lucailvec/thermore_insulating_machine/report.odt

Manuale

La macchina per la misurazione dell’ RCT di un materiale richiede di: poter impostare la temperatura del piano riscaldato e dell’ambiente. Una volta posto il materiale sopra al piano e richiuso lo sportello la macchina deve raggiungere le temperature impostate e elaborando i dati acquisiti ricavare i valori RCT e CLO del materiale.

Per poter eseguire una rilevazione per prima cosa spegnere il dispositivo se non già spento. Per poterlo spegnere abbassare la leva del differenziale indicata con l’etichetta SUPPLY.

Aprire lo sportello e posizionare il materiale al di sopra del piatto. Richiudere correttamente lo sportello e alzare la leva SUPPLY.

A questo punto la macchina mostra a display che è entrata nello stato IDLE che consente all’operatore di impostare la temperatura della camera e la temperatura del corpo attraverso i bottoni indicati rispettivamente con AMB e PIATTO.

Nello stato IDLE la macchina monitora solamente i valori, il piatto riscaldante e il compressore non vengono attivati.

Una volta settata la temperatura desiderata è possibile premendo a fondo il bottone NEXT, questo farà passare lo stato del sistema allo stato HEATING.

Da ora in poi la macchina non richiede più l’intervento di un operatore ed è completamente autonoma.

Nello stato HEATING prima viene fatta raffreddare la camera climatica alla temperatura impostata, quando la temperatura rimane stabile viene acceso in modo graduale il piatto riscaldato.

Una volta che vengono rilevate 10 misurazioni in cui la mediana rilevata dalla temperatura del piatto e della camera oscillano in un intorno della temperatura impostata la macchina passa nello stato di MEASURAMENT.

In quest’ ultimo stato la macchina, che ha raggiunto uno stato stabile, esegue 40 rilevazioni della potenza utilizzata e una volta superate le 40 rilevazioni restituisce la mediana delle più recenti 40 rilevazioni.

Al termine delle rilevazioni è possibile spegnere la macchina tramite la leva SUPPLY aspettando lo spegnimento completo del DISPLAY per poter rieffettuare una nuova misura.

Scelte progettuali:

Software

Si è scelto di adottare una metodologia bottom-up con un primo obiettivo di realizzare un software o sketch che possa testare i singoli componenti.

Per far ciò si sono sviluppati i componenti software che mappassero i componenti collegati alla scheda di controllo Arduino quali NTC, piastre riscaldanti, teleruttori, display e bottoni.

Una volta costruiti i singoli componenti si è realizzato il programma che usasse ogni componente in modo che, una volta applicata la scheda alla macchina, si sarebbe potuto testare il funzionamento di ogni singolo componente. Questo codice verrà utilizzato per controllare che durante lo spostamento della macchina da un luogo ad un altro non si sia interrotto nessun cavo e che ogni componente non abbia smesso di funzionare.

E’ stata prevista anche la presenza di procedure automatiche di spegnimento nel caso di interruzione del collegamento con i sensori di temperatura per poter evitare il surriscaldamento eccessivo del piano riscaldante.

Una volta progettate le classi o componenti che rappresentano gli elementi reali si è deciso di inglobarli nei singoli controlli (Proporzionale-Integrativo-Derivativo con isteresi e senza) per la gestione della camera climatica(1) e delle componenti riscaldanti(2).

Per indicare la dispersione delle rilevazioni intorno alla media non viene usata la deviazione standard ma il coefficiente di variazione.

Più si avvicina allo zero più le rilevazioni sono nell’intorno della media e quindi le rilevazioni sono stabili.

https://it.wikipedia.org/wiki/Coefficiente_di_variazione

Per filtrare i valori della potenza e temperatura ottenuta dai sensori viene usata la mediana che fornisce un risultato più attendibile rispetto alla media in quanto è meno sensibile a valori lontani dalla media.

Per effettuare la regolazione del piatto riscaldante e della camera climatica si è deciso di implementare un controllore PID anagolico ed uno discreto inoltre è stata implementata una nuova funzionalità di controllo (proportional on measurement http://brettbeauregard.com/blog/2017/06/introducing-proportional-on-measurement/

).

I bottoni sono dotati di software anti-rimbalzo dove è settabile a piacere la frequenza di lettura.

Le fasi di display e invio al pc tramite USB dei dati è stato minimizzato, questo consente di avere un sistema più reattivo: anche per quanto riguarda l’utilizzo di display è stata prevista la possibilità di scegliere la frequenza di aggiornamento della schermata.

Per il display è stato pensato di sviluppare un sistema a finestre ed in modo ciclico è possibile scegliere quali elementi far mostrare sullo schermo.

Si è implementata la possibilità di limitare la potenza fornita ai piatti per evitare l’effetto “overshoot” dei controlli pid.

Hardware

E’ stata progettata una nuova scheda di controllo e sono stati eliminati tutti i fili pinwire con esclusione del connettore del display: ora accidentalmente è più difficile rimuovere un filo collegato.

Per gestire l’accensione e lo spegnimento della ventola di areazione e dei componenti riscaldanti si è utilizzato un mosfet ttl (https://www.sparkfun.com/products/10213) da sovradimensionato per le correnti in gioco. Questo consente di avere maggiori certezze sulla potenza erogata dal piano riscaldante.

La componente che governa l’accensione e lo spegnimento del compressore del frigo è rimasta invariata.

La ventola di raffreddamento è stata riposizionata per migliorare il raffreddamento.

Si è proceduto al ricablaggio completo di tutti i componenti impiegando canaline e scatole di derivazione.

Sono stati aggiunti dei led di segnalazione per mostrare l’accensione e lo spegnimento dei piatti riscaldanti: non servirà più aprire lo sportello per osservare se i componenti riscaldanti stanno lavorando.

E’ stato aggiunto un diodo di protezione verso l’alimentazione e un circuito di filtraggio dei disturbi verso le ntc.
