lucailvec/thermore_insulating_machine/Conclusioni.odt

Luca Vecchi

Giovedì 27 Agosto

Come da mail accennato la componente del frigorifero che dovrebbe raffreddare non raffredda.

Ieri dalle 18 alle 20:15 l’ho lasciata accesa con il piatto riscaldante spento e ha raggiunto la temperatura di 15°. Ho controllato anche mediante l’utilizzo di altre due sonde esterne (due termocoppie) che purtroppo indicavano la stessa temperatura fornita dal sensore installato nella macchina.

La taratura della macchina non sono riuscita a portarla a termine in quanto con 37 gradi di temperatura del piatto e 25 gradi dell’ambiente la temperatura dell’ambiente era costantemente al di sopra dei 26 gradi nonostante il frigo continuasse ad essere acceso e a raffreddare.

A questo punto ci sono varie possibilità tra cui:

- Ricaricare il frigo e verificare se la non refrigerazione era data dalla mancanza di gas causata a sua volta da una perdita.
- Sostituire il frigorifero

In ogni caso chiedo di poter procedere a portare la macchina da un frigorista per effettuare la ricarica del gas sottoponendolo prima ad una prova sotto vuoto per verificare eventuali perdite. Terminata la ricarica riprenderei la macchina sotto esame per rieffettuare la taratura delle componenti software alle varie temperature.

In attesa di un vostro riscontro

Luca Vecchi
