lucailvec/thermore_insulating_machine/RTC_MESUREMENT_MACHINE_0_1/RTC_MESUREMENT_MACHINE_0_1.ino

#include "include.h"
#include "pinout.h"
#include "setup.h"
#define DEBUG 2

//piatto vuoto 18.5 gradi
//2.32 minuti di prima oscillazione
Fridge fridge(FRIDGE);
Plate plate(PLATE, 255);
//Plate ring(RING, 180);

Button btnPUP(BTN_TEMP_PLATE_UP, 500);
Button btnPDOWN(BTN_TEMP_PLATE_DOWN, 500);
Button btnAUP(BTN_TEMP_AMB_UP, 500);
Button btnADOWN(BTN_TEMP_AMB_DOWN, 500);
Button btnNEXT(BTN_NEXT, 500);

WrapperButton buttonPlate(35, &btnPUP, &btnPDOWN,minTempPlate,maxTempPlate);
WrapperButton buttonAmb(20, &btnAUP, &btnADOWN,minTempAmb,maxTempAmb);

PCF8574_HD44780_I2C lcd(0x27,20,4);

#define RNOMINALE 100000
#define TNOMINALE 25
#define BCOEFF 3955

TempSensor tAmb(TEMP_AMB, BCOEFF, 297000, 100000, 25);
TempSensor tPlate(TEMP_PLATE, BCOEFF, 99800, 100000, 25);


//PID control

//Define Variables we'll be connecting to
double //Setpoint, è il valore del wrapper button
//tempPlate, //aggiornato tramite tPlate.getTemp();
outputPlate; //

//Specify the links and initial tuning parameters
//double KpPlate=2, KiPlate=1.2, KdPlate=0.0;
double KpPlate=2, KiPlate=0.3, KdPlate=0.0;

AnalogPid platePid(&tPlate.value, & outputPlate,& (buttonPlate.dValue) , KpPlate, KiPlate,KdPlate);

Fridge::STATE outputAmb;

double KpAmb=0.5, KiAmb=0.45;
double threshold = 5.0;
long interval = 20000;

DiscretePid fridgePid(&tAmb.value,&outputAmb, & (buttonAmb.dValue),KpAmb,KiAmb,interval,threshold);

//Statistics control

double _ar1[40];
Measurable statics1(500,_ar1,40);

const int NUMOFRCTMEASURE=75;
double _arRct[NUMOFRCTMEASURE];
Measurable cycleRCT(0,_arRct,NUMOFRCTMEASURE);
int counterRCT=-20;

double _ar2[20];
Measurable totalRCT(0,_ar2,20);
const long NUMMEASUREMENT=20;
int counterRCTCycle=0;

//variabili del supervisor

enum STATEMODE { NORMAL, RCTIDLE, MEASURESETUP, CLEAN, MEASURE, RCTINSERT, RCTINSERT1, RCTINSERT2, RCTINSERT3, RCTINSERTEND };
STATEMODE stateMode = STATEMODE::NORMAL;
int cifra;
double tempRCT;

enum STATE { IDLE, COOLING, HEATING, MEASUREMENT, END ,SELECTIONMODE};
STATE stato= STATE::IDLE;

const int intervalCallDisplay=1000,intervalDisplay=5000;
long lastDisplay=0,displayTimer1=0,displayTimer2=0;
long timeOfLoop;//,lastDisplay=0;;

long lastTimeReadStableState=0, intervalReadStableState=3500; 
unsigned int counterStableState=0;
const unsigned int NUMBEROFSTABLESTATE = 40;

void setup() {
  #ifdef DEBUG
    Serial.begin(2000000);
  #endif
  #ifdef DEBUG
    Serial.print("RCT0 20 C: "); buttonAmb.set(20); Serial.println(readRCT0(),4);
    Serial.print("RCT0 10 C: "); buttonAmb.set(10); Serial.println(readRCT0(),4);
    Serial.print("RCT0 0 C: "); buttonAmb.set(0); Serial.println(readRCT0(),4);
    Serial.print("RCT0 -10 C: "); buttonAmb.set(-10); Serial.println(readRCT0(),4);
    buttonAmb.set(20);
  #endif
 setLimit();
  
  lcd.init();                        
  lcd.backlight();      
  lcd.clear();

  pinMode(FAN,OUTPUT);
  analogWrite(FAN,255);
  delay(200);
  analogWrite(FAN,35);

  for(int i = 0 ; i < 5 ; i++){
  if(btnPUP.getState()==Button::STATE::DOWN && btnPDOWN.getState()==Button::STATE::DOWN){
    stato = STATE::SELECTIONMODE;
  }
  delay(100);
  }
}

void loop() {
  timeOfLoop=millis();
  /*supervisor.*/
  _update();// aggiorna ed esegue calcoli sui valori aggiornati
  /*supervisor.*/
  _run();//esegua le operazioni di modifica dello stato quale accensione o spegnimento degli elementi
  
  if(millis()- lastDisplay >= intervalCallDisplay){
    _display();//mostra a display i valori
    lastDisplay=millis();
/*
 lcd.setCursor(0,0);           lcd.print(F("Pmean: "));          lcd.print(statics1.median());
          lcd.setCursor(11,0);          lcd.print(F("Pcv: "));          lcd.print(statics1.cv());
          lcd.setCursor (0,1);          lcd.print(F("Tmean:  "));          lcd.print(statics2.median());
          lcd.setCursor(11,1);          lcd.print(F("Tcv:"));          lcd.print(statics2.cv());
 */
    #ifdef DEBUG
      Serial.print(F("OutAmb: "));
      Serial.print(outputPlate);
      Serial.print(F(" outPidAmb: "));
      Serial.print(fridgePid._output);
      Serial.print(F(" threshold: "));
      Serial.print(fridgePid._threshold);
      Serial.print(F(" | OutPlate: "));
      Serial.print(outputPlate);/*
      Serial.print(" outputMedian: ");
      Serial.print(statics1.median());
      Serial.print(" outputCv: ");
      Serial.print(statics1.cv());*/
      Serial.print(F(" dTime: "));
      Serial.println(millis() - timeOfLoop);
      Serial.print(F("TempPlate: "));
      Serial.print(tPlate.value);
      Serial.print(F(" SetPointPlate: "));
      Serial.println(buttonPlate.value);
      Serial.print(F("TempAmb: "));
      Serial.print(tAmb.value);
      Serial.print(F(" SetPointPlate: "));
      Serial.println(buttonAmb.value);
      Serial.print(F("Stato corrente: "));
      Serial.print(stato);
      Serial.print(F(" StateMode: "));
      Serial.print(stateMode);
      Serial.print(F(" RCT0: "));
      Serial.println(RCT0,3);
    #endif
  }

}

//var glob stato
void _run(){
  switch(stato){
    case STATE::IDLE:
      fridge.turn(Fridge::STATE::OFF);
    //  plate.turn(Plate::STATE::OFF);
      plate.set(0);
      break;
    case STATE::COOLING:
     // plate.turn(Plate::STATE::OFF);
      fridge.turn(outputAmb);
      analogWrite(FAN,255);
      break;
    case STATE::HEATING:
     // plate.turn(Plate::STATE::ON);
      analogWrite(FAN,30);
      fridge.turn(outputAmb);
      plate.set(outputPlate);
      break;
    case STATE::MEASUREMENT:
      fridge.turn(outputAmb);
      plate.set(outputPlate);
      break;
    case STATE::END:
      plate.turn(Plate::STATE::OFF);
      fridge.turn(outputAmb);
      plate.set(0);
      break;
    case STATE::SELECTIONMODE:
      fridge.turn(Fridge::STATE::OFF);
      plate.set(0);
    break;
  }
}

void _update(){
  switch(stato){
    case STATE::IDLE:
      tAmb.checkChange();
      tPlate.checkChange();
      buttonPlate.checkChange();
      buttonAmb.checkChange();
      
      if(btnNEXT.getState()==Button::STATE::DOWN){     
        if(stateMode==STATEMODE::CLEAN || stateMode==STATEMODE::MEASURE)
          RCT0 = 0;// lo prende dalla eeprom
        else
          RCT0 = readRCT0();
        stato=STATE::COOLING;
        displayTimer1=0;
        displayTimer2=0;
        lcd.clear();
       
      }
      
      break;
     case STATE::COOLING:
     
      tAmb.checkChange();
      tPlate.checkChange();
      fridgePid.compute();
        if(buttonAmb.value  + 0.3 >= tAmb.value ){
          stato=STATE::HEATING;
          displayTimer1=0;
          displayTimer2=0;
          break;
        }
      break;
      
    case STATE::HEATING:
      tAmb.checkChange();
      tPlate.checkChange();
      platePid.compute();
      fridgePid.compute();
     if(millis()-lastTimeReadStableState>= intervalReadStableState){
      if(buttonAmb.value - 1.6 <= tAmb.value && buttonAmb.value + 0.8 >= tAmb.value && buttonPlate.value - 0.8 <= tPlate.value && buttonPlate.value + 1.0 >= tPlate.value){
        counterStableState++;
      }
       else{
        counterStableState=0;
       }
        lastTimeReadStableState= millis();
      }
      //counter time is : NUMBEROFSTABLESTATE * itnervalReadStableState
      if(counterStableState==NUMBEROFSTABLESTATE){
     // if(counterStableState==3){
          stato=STATE::MEASUREMENT;
          displayTimer1=0;
          displayTimer2=0;
          lcd.clear();
          //todo azzerare statics1 e 2
          statics1.reset();
      }
    break;
    
    case STATE::MEASUREMENT:

    if(btnNEXT.getState()==Button::STATE::DOWN){
       if(stateMode==STATEMODE::MEASURE){
             writeRCT0(totalRCT.average(counterRCTCycle));
          }
        stato=STATE::END;
        displayTimer1=0;
        displayTimer2=0;
        lcd.clear();
      }
    
      tAmb.checkChange();
      tPlate.checkChange();
      platePid.compute();
      fridgePid.compute();

      statics1.newVal(outputPlate);

      if(counterRCT>=NUMOFRCTMEASURE){
          if(counterRCTCycle>=NUMMEASUREMENT){
            if(stateMode==STATEMODE::MEASURE){
             writeRCT0(totalRCT.average(counterRCTCycle));
            }
            stato=STATE::END;
            displayTimer1=0;
            displayTimer2=0;
            lcd.clear();
          }else{
            /*if(stateMode==STATEMODE::MEASURE){
              
            }else{*/
             totalRCT.newVal(cycleRCT.median(counterRCT));
            
            counterRCT=0;
            counterRCTCycle++;
          }
      }

     if(millis()-lastTimeReadStableState>= intervalReadStableState){
      if(counterRCT<=-1){
       counterRCT++;
      }else {
        double tempRCT = convertToRCT(statics1.median(counterRCT),tPlate.value,tAmb.value);
        /*if(tempRCT<=0.010||tempRCT >= 10)
          break;*/
        counterRCT++;
        if(stateMode == STATEMODE::MEASURE || stateMode==STATEMODE::CLEAN){
         cycleRCT.newVal((tempRCT));
        }else 
          cycleRCT.newVal( normalize(tempRCT));
      }
      
      lastTimeReadStableState=millis();
     }

     
      break;

    case STATE::END:
      tAmb.checkChange();
      tPlate.checkChange();
      fridgePid.compute();
      plate.turn(Plate::STATE::OFF);
      
  
      
      if(btnNEXT.getState()==Button::STATE::DOWN){
        stateMode=STATEMODE::NORMAL;
        stato=STATE::IDLE;
        displayTimer1=0;
        displayTimer2=0;
        lcd.clear();
        counterRCT=-30;
      }
      break;

    case STATE::SELECTIONMODE://inseriamo un rct er 20,10,0 e -10 
      if(millis()-lastTimeReadStableState>= 200){
        tAmb.checkChange();
        tPlate.checkChange(); //NORMAL, RCTIDLE, RCTAMBTEMPSELECTION, RCTMEASURE
  
        //cambiare la modalità
        if(stateMode==STATEMODE::NORMAL || stateMode == STATEMODE::RCTIDLE || stateMode == STATEMODE::MEASURESETUP || stateMode ==STATEMODE::CLEAN)
          if(btnPUP.getState() == Button::STATE::DOWN || btnPDOWN.getState() == Button::STATE::DOWN){
            lcd.clear();
            switch(stateMode){
              case STATEMODE::NORMAL: stateMode = STATEMODE::RCTIDLE; break;
              case STATEMODE::RCTIDLE: stateMode = STATEMODE::MEASURESETUP; break;
              case STATEMODE::MEASURESETUP: stateMode = STATEMODE::CLEAN; break;
              case STATEMODE::CLEAN: stateMode = STATEMODE::NORMAL; break;
            }
          }
  
        switch(stateMode){
            case STATEMODE::MEASURE: 
              if(btnAUP.getState() == Button::STATE::DOWN || btnADOWN.getState() == Button::STATE::DOWN){
              
              if(buttonAmb.value -10 <= -20)
                 buttonAmb.set(20);
              else
                 buttonAmb.set(buttonAmb.value -10);
            }
            break;
           case STATEMODE::RCTINSERT:
             if(btnAUP.getState() == Button::STATE::DOWN || btnADOWN.getState() == Button::STATE::DOWN){
              if(buttonAmb.value -10 <= -20)
                 buttonAmb.set(20);
              else
                 buttonAmb.set(buttonAmb.value -10);
             }
           break;
           case STATEMODE::RCTINSERT1:
           case STATEMODE::RCTINSERT2:
           case STATEMODE::RCTINSERT3:
                if(btnPUP.getState() == Button::STATE::DOWN)
                  cifra++;
                else if (btnPDOWN.getState() == Button::STATE::DOWN)
                  cifra--;
                break;
          }
        
        if(btnNEXT.getState()==Button::STATE::DOWN){
          switch(stateMode){
            case STATEMODE::NORMAL: stato = STATE::IDLE; break;
            case STATEMODE::RCTIDLE: stateMode = STATEMODE::RCTINSERT; break;
            case STATEMODE::MEASURESETUP: stateMode = STATEMODE::MEASURE; break;
            case STATEMODE::MEASURE: stato= STATE::COOLING; break;
            case STATEMODE::RCTINSERT: stateMode = STATEMODE::RCTINSERT1;tempRCT= 0.; cifra=5; break;
            case STATEMODE::RCTINSERT1: tempRCT += 0.1 * cifra; cifra = 5; stateMode = STATEMODE::RCTINSERT2; break;
            case STATEMODE::RCTINSERT2: tempRCT += 0.01 * cifra; cifra = 5; stateMode = STATEMODE::RCTINSERT3; break;
            case STATEMODE::RCTINSERT3: tempRCT += 0.001 * cifra; cifra = 5; stateMode = STATEMODE::RCTINSERTEND; writeRCT0(tempRCT); break;
            case STATEMODE::RCTINSERTEND: writeRCT0(tempRCT);
            case STATEMODE::CLEAN: stato = STATE::IDLE; break;
          }
            //displayTimer1=0;
            displayTimer2=0;
            lcd.clear();
       }
       lastTimeReadStableState=millis();
      }
  }
}

//long intervalDisplay=3000,lastDisplay=0,displayTimer1=0,displayTimer2=0,_numMesurement=30;

//var glob stato
void _display(){
  if(displayTimer1==0 && displayTimer2==0)
   displayTimer2=millis();
  switch(stato){
    case STATE::IDLE:
      if(displayTimer1==0){//diplayTimer1 mostra a che fase è del singolo stato mentre displayTimer2 indica quale informazione stampare a video
         lcd.setCursor(0,0);          lcd.print(F("Stato: IDLE"));
         lcd.setCursor(0,2);          lcd.print(F("POI premi  NEXT"));
         lcd.setCursor(0,1);          lcd.print(F("Sett. la temp"));
         if(millis() - displayTimer2 >= intervalDisplay){
            displayTimer1=1;
            lcd.clear();
         }
      }else{
        lcd.setCursor(0,0);        lcd.print(F("Ta: "));        lcd.print(tAmb.value,1);
        lcd.setCursor(12,0);        lcd.print(F("Tap:"));        lcd.print(buttonAmb.dValue,1);
        lcd.setCursor (0,1);        lcd.print(F("Tc:  "));        lcd.print(tPlate.value,1);
        lcd.setCursor(12,1);        lcd.print(F("Tcp:"));        lcd.print(buttonPlate.value);
     }
      if(stateMode == STATEMODE::CLEAN){
        lcd.setCursor(0,3); lcd.print(F("Bps rct0 e tarat."));
      }else{
        lcd.setCursor(0,3); lcd.print(F("Rct0: ")); lcd.print(readRCT0(),4);
      }
      
      break;
    case STATE::COOLING:
      if(displayTimer1==0){
       lcd.setCursor(0,0);        lcd.print(F("Stato: COOLING"));       
       lcd.setCursor(0,2) ;        lcd.print(F("Fase di raffreddamento"));
       lcd.setCursor(0,1);        lcd.print(F("Attendere prego."));
       if(millis() - displayTimer2 >= intervalDisplay){
        displayTimer1=1;
        lcd.clear();
       }
      }else{
        lcd.setCursor(0,0);          lcd.print(F("Ta: "));          lcd.print(tAmb.value,1);
        lcd.setCursor(0,1);          lcd.print(F("Tap:"));          lcd.print(buttonAmb.dValue,1);
        //lcd.setCursor (0,2);         lcd.print(F("T da raggiungere:  "));  
        //lcd.setCursor(0,3); lcd.print(calculateCollingValue(buttonAmb.dValue),1);
      }
    break;
    case STATE::HEATING:
      if(displayTimer1==0){
       lcd.setCursor(0,0);        lcd.print(F("Stato: HEATING"));       
       lcd.setCursor(0,2) ;        lcd.print(F("Fase di stabilizzazione"));
       lcd.setCursor(0,1);        lcd.print(F("Attendere prego."));
       if(millis() - displayTimer2 >= intervalDisplay){
        displayTimer1=1;
        displayTimer2=millis();
        lcd.clear();
       }
      }else if(displayTimer1==1) {
          lcd.setCursor(0,0);          lcd.print(F("Ta: "));          lcd.print(tAmb.value,1);
          lcd.setCursor(12,0);          lcd.print(F("Tap:"));          lcd.print(buttonAmb.dValue,1);
          lcd.setCursor (0,1);         lcd.print(F("Tc:  "));          lcd.print(tPlate.value,1);
          lcd.setCursor(12,1);          lcd.print(F("Tcp:"));          lcd.print(buttonPlate.value);
          if(millis() - displayTimer2 >= intervalDisplay){
            displayTimer1=2;
            displayTimer2=millis();
            lcd.clear();
           }
       }else if (displayTimer1==2){
          lcd.setCursor(0,0);           lcd.print(F("OutP: "));          lcd.print(outputPlate);
          //lcd.setCursor(11,0);          lcd.print(F("Pcv: "));          lcd.print(statics1.cv());
          lcd.setCursor (0,1);          lcd.print(F("OutA: "));          lcd.print(outputAmb);
          //lcd.setCursor(11,1);          lcd.print(F("Tcv:"));          lcd.print(statics2.cv());
          lcd.setCursor(0,2);          lcd.print(F("countSS:"));          lcd.print(counterStableState);
          lcd.setCursor(0,3); lcd.print(F("Goal: ")); lcd.print(NUMBEROFSTABLESTATE);
          if(millis() - displayTimer2 >= intervalDisplay){
            displayTimer1=1;
            displayTimer2=millis();
            lcd.clear();
           }
        }
      
      break;
    case STATE::MEASUREMENT://TODO
      if(displayTimer1==0){//diplayTimer1 mostra a che fase è del singolo stato mentre displayTimer2 indica quale informazione stampare a video
        lcd.setCursor(0,0);        lcd.print(F("Stato: MISURA"));       
       lcd.setCursor(0,1);        lcd.print(F("Campion. in corso."));
       lcd.setCursor(0,2) ;        lcd.print(F("Premere next per fermare le misurazioni"));
        if(millis() - displayTimer2 >= intervalDisplay){
            displayTimer1=1;
            lcd.clear();
         }
      }else if(displayTimer1==1) {
            if(counterRCT >= 0 ){
              double temp=cycleRCT.median(counterRCT);
              lcd.setCursor(0,0);         lcd.print(F("RCTinst: "));        lcd.print(temp,4);
              lcd.setCursor(0,1);        lcd.print(F("CLOinst: "));        lcd.print(rct2Clo(temp),4);
              temp=totalRCT.average(counterRCTCycle);
              if(counterRCTCycle>=1){
              lcd.setCursor(0,2);         lcd.print(F("RCTm: "));        lcd.print(temp,4);
              lcd.setCursor(0,3);        lcd.print(F("CLOm: "));        lcd.print(rct2Clo(temp),4);
              }
              else{
                lcd.setCursor(0,2);         lcd.print(F("RCTm: wait")); 
                lcd.setCursor(0,3);        lcd.print(F("CLOm: wait")); 
              }
               if(millis() - displayTimer2 >= intervalDisplay){
                displayTimer1=2;
                displayTimer2=millis();
                lcd.clear();
               }
            }else{
              lcd.setCursor(0,2);         lcd.print(F("Campion. di stabilz."));
              lcd.setCursor(0,3);         lcd.print(F("in corso "));
            }
      }else if (displayTimer1==2){
        lcd.setCursor(0,0);         lcd.print(F("Ta: "));        lcd.print(tAmb.value,1);   lcd.print(F(" Tc: "));        lcd.print(tPlate.value,1);
        lcd.setCursor(0,2); lcd.print(F("N inst: ")); lcd.print(counterRCT); lcd.print(F(" di: ")); lcd.print(NUMOFRCTMEASURE);
        lcd.setCursor(0,3); lcd.print(F("N media: ")); lcd.print(counterRCTCycle); lcd.print(F(" di: ")); lcd.print(NUMMEASUREMENT);
        
        if(millis() - displayTimer2 >= intervalDisplay){
          displayTimer1=1;
          displayTimer2=millis();
          lcd.clear();
         }
       }
      
      break;

    case STATE::END:   
      if(displayTimer1==0){//diplayTimer1 mostra a che fase è del singolo stato mentre displayTimer2 indica quale informazione stampare a video
         lcd.setCursor(0,0);          lcd.print(F("Misura conclusa."));
         lcd.setCursor(0,1);          lcd.print(F("Premi NEXT per"));
         lcd.setCursor(0,2);          lcd.print(F("riavviare la macchina"));
         if(millis() - displayTimer2 >= intervalDisplay + 10000){
            displayTimer1=1;
            lcd.clear();
         }
      }else{
        if(stateMode==STATEMODE::MEASURE){
          lcd.setCursor(0,0);        lcd.print(F("Rct0 calcolato: "));       
          lcd.setCursor (0,1);        lcd.print(F("RCT0 medio: "));        lcd.print(readRCT0(),4);
          lcd.setCursor(0,2); lcd.print(F("Tamb: ")); lcd.print(buttonAmb.value);
          lcd.setCursor(0,3); lcd.print(F("Riaccendi la macchina")); 
         }else if (stateMode== STATEMODE::CLEAN){
          lcd.setCursor(0,0);        lcd.print(F("Rct senza taratura"));       
          lcd.setCursor (0,1);        lcd.print(F("RCT medio: "));       lcd.print(totalRCT.average(counterRCTCycle),4);
          lcd.setCursor(0,2); lcd.print(F("Tamb: ")); lcd.print(buttonAmb.value);
          lcd.setCursor(0,3); lcd.print(F("Riaccendi la macchina")); 
         } else{
        lcd.setCursor(0,0);        lcd.print(F("Ta: "));        lcd.print(buttonAmb.value,1);     lcd.print(F(" Tp:"));        lcd.print(buttonPlate.dValue,1);
        lcd.setCursor (0,1);        lcd.print(F("RCT medio:  "));        lcd.print(totalRCT.average(counterRCTCycle),4);
        lcd.setCursor(0,2);        lcd.print(F("Clo medio:"));        lcd.print(rct2Clo(totalRCT.average(counterRCTCycle)),4);
        lcd.setCursor(0,3); lcd.print(F("Calc. su ")); lcd.print(counterRCTCycle);
         }
     }
      break;
     case STATE::SELECTIONMODE:
         if(displayTimer1==0){//diplayTimer1 mostra a che fase è del singolo stato mentre displayTimer2 indica quale informazione stampare a video
         lcd.setCursor(0,0);          lcd.print(F("Stato: config"));
         lcd.setCursor(0,1);        lcd.print(F("Usa btn PIATTO")); 
         lcd.setCursor(0,2); lcd.print(F("cambiare la mod."));  
         lcd.setCursor(0,3); lcd.print(F("Conferma con NEXT"));       
          
         if(millis() - displayTimer2 >= intervalDisplay + 4000){
            displayTimer1=1;
            displayTimer2=millis();
            lcd.clear();
         }
      }else{
        
          
         /* if(millis() - displayTimer2 >= intervalDisplay + 10000){
              displayTimer1=1;
              lcd.clear();
           */   
          switch(stateMode){
          case STATEMODE::NORMAL: lcd.setCursor(0,0);          lcd.print(F("Mod: normale")); lcd.setCursor(0,1); lcd.print(F("Premi NEXT per")); lcd.setCursor(0,2); lcd.print(F("fare una misura")); break;
          case STATEMODE::CLEAN: lcd.setCursor(0,0);          lcd.print(F("Mod: clean"));  lcd.setCursor(0,1); lcd.print(F("Senza rct0 e tar.")); lcd.setCursor(0,2); lcd.print(F("Premi NEXT per")); lcd.setCursor(0,3); lcd.print(F("fare una misura")); break;
          case STATEMODE::RCTIDLE: lcd.setCursor(0,0);          lcd.print(F("Mod: inserimento")); break;
          case STATEMODE::MEASURE:lcd.setCursor(0,0);          lcd.print(F("Con Amb selez")); 
              lcd.setCursor(0,1); lcd.print(F("la temp. poi NEXT")); 
             lcd.setCursor(0,1);          lcd.print(F("Premi NEXT per misura.")); 
          lcd.setCursor(0,2);   lcd.print(F("TempAmb: ")); lcd.print(buttonAmb.dValue);
          lcd.setCursor(0,3);   lcd.print(F("RCTO salv: ")); lcd.print(readRCT0(),3);
          break;
          case STATEMODE::MEASURESETUP: lcd.setCursor(0,0); lcd.print(F("Mod: misura")); lcd.setCursor(0,1); lcd.print(F("Misura, salva l'rct0")); break;
         case STATEMODE::RCTINSERT: lcd.setCursor(0,0);   lcd.print(F("Inserisci la tAmb")); 
          lcd.setCursor(0,1);   lcd.print(F("Usa btnAmb poi NEXT"));
          lcd.setCursor(0,2);   lcd.print(F("TempAmb: ")); lcd.print(buttonAmb.dValue);
          lcd.setCursor(0,3);   lcd.print(F("RCTO salv: ")); lcd.print(readRCT0(),3);
         break;
         case STATEMODE::RCTINSERT1:
         case STATEMODE::RCTINSERT2:
         case STATEMODE::RCTINSERT3:
             lcd.setCursor(0,0);   lcd.print(F("modif. la ")); lcd.print(stateMode- RCTINSERT); lcd.print(F(" cifra"));
             lcd.setCursor(0,1); lcd.print(F("Unità: ")); lcd.print(cifra);
             lcd.setCursor(0,2); lcd.print(F("RCT0: ")); lcd.print(tempRCT,3);
             lcd.setCursor(0,3); lcd.print(F("Premi NEXT per conf."));
            break;
         case STATEMODE::RCTINSERTEND:
             lcd.setCursor(0,0);   lcd.print(F("Scrittura")); 
             lcd.setCursor(0,1); lcd.print(F("RCT0: ")); lcd.print(tempRCT);
             lcd.setCursor(0,2); lcd.print(F("Per tAmb: ")); lcd.print(buttonAmb.dValue,1);
             lcd.setCursor(0,3); lcd.print(F("Spegni e riaccendi."));
        }
     }
     break;
  }
}

int getIndexRCT0(){
  return ((buttonAmb.value + 10)/10)*sizeof(double);
}
void writeRCT0(double val){
  int t= getIndexRCT0();

   #ifdef DEBUG
     float f;
      EEPROM.get(getIndexRCT0(),f);
   Serial.print(F("EEPROM Scrivo:")); Serial.print(val); Serial.print(F(" in : ")); Serial.print(t); Serial.print(F(" al posto di:")); Serial.println((double)f);
  #endif
   EEPROM.put(t,(float)val);
}

double readRCT0(){
  float f;
  EEPROM.get(getIndexRCT0(),f);
  #ifdef DEBUG
  Serial.print(F("EEPROM Ho letto:")); Serial.print(f); Serial.print(F(" in : ")); Serial.println(getIndexRCT0());
  #endif
  return (double)f;
}

double convertToRCT(double dutyCyclePlate,double tempPlate,double tempAmb){
  //total area = 0.215*0.215 = 0,046225
  //double res= 1.5; //ohm 12V / 1.5 = 8A
  //W = V * I = 12*8 = 96 Watt
 // double p = 

  return 0.046225 *(tempPlate-tempAmb)/(96. *(dutyCyclePlate/255.))-RCT0;
}

void callback(){
  lcd.clear();
  lcd.setCursor(0,0);
  lcd.print(F("ATTENZIONE, controllare sensori"));
  Serial.println("ATTENZIONE errore, chiamata callback");
  fridge.turn(Fridge::STATE::OFF);
  plate.turn(Plate::STATE::OFF);
//  ring.turn(Plate::STATE::OFF);
  while(1){
    Serial.print(".");
  }
}
void setLimit(){
  tAmb.setLimit(30,900,callback);
  tPlate.setLimit(30,900,callback);
//  tRing.setLimit(30,900,callback);
  
}

/*
 * 
 // a 20 vado in basso di 5 gradi, a -10 vado in basso di 10 gradi
 //   Y = 0.8333*X - 11.67
 
 * 
 */
//Y = 0.8333*X - 11.67
float rct2Clo(float val){
  return val * 6.45;
}

double normalize(double val){
      return alpha*val  + beta ;
}
