lucailvec/thermore_insulating_machine/RTC_MESUREMENT_MACHINE_0_1/pinout.h

const int FRIDGE = 2;
const int BTN_TEMP_PLATE_UP = 3;
const int BTN_TEMP_PLATE_DOWN = 4;
const int BTN_TEMP_AMB_UP = 5;
const int BTN_TEMP_AMB_DOWN = 6;
const int BTN_NEXT = 7;
const int PLATE = 9;
const int RING = 10;
const int FAN = 11;

const int TEMP_PLATE = A0;
const int TEMP_RING = A2;
const int TEMP_AMB = A1;
