lucailvec/thermore_insulating_machine/RTC_MESUREMENT_MACHINE_0_1/DiscretePid.cpp

#include "DiscretePid.h"

#ifndef PID_V1_H
#include <PID_v1.h>
#endif

#include "Fridge.h"

DiscretePid::DiscretePid(double * mesure, Fridge::STATE * output,double * setpoint,double kp,double ki,long interval, double threshold){
  _outputDiscrete = output;
  _threshold = threshold;
  _interval = interval;
  _mesure=mesure;
  _setpoint = setpoint;
  pid = new PID( mesure, &_output, setpoint, kp, ki, 0., P_ON_M, REVERSE);
  pid->SetMode(AUTOMATIC);
  pid->SetOutputLimits(0,255);
}

void DiscretePid::compute(){
  pid->Compute();
  if(millis() - _lastOn>=_interval ) {//da controllare perchè non so come venga gestito il reverse
    if(*_mesure<=*_setpoint)// TODO togliere nel caso si aggiunge la componente derivativa
      *_outputDiscrete=Fridge::STATE::OFF;
    else
    *_outputDiscrete = ( _output >_threshold) ?Fridge::STATE::ON : Fridge::STATE::OFF; //a causa del DIRECT
    _lastOn = millis();
  }
}
/*
void DiscretePid::changeSetPoint(double * newSetPoint){
  pid->setpoint = newSetPoint; 
}*/
