lucailvec/thermore_insulating_machine/RTC_MESUREMENT_MACHINE_0_1/AnalogPid.cpp

#include "AnalogPid.h"

#ifndef PID_V1_H
#include <PID_v1.h>
#endif


AnalogPid::AnalogPid(double *mesure,double *output,double *setpoint,double kp,double ki,double kd){
  /*#ifdef DEBUG
    Serial.print("Inizializzo analogPID con setpoint:");
    Serial.print(*setpoint);
    Serial.print(" output:");
    Serial.print(*output);
    Serial.print("mesure ");
    Serial.println(*mesure);
  #endif*/
  pid = new PID(mesure , output,setpoint , kp, ki, kd, P_ON_M, DIRECT);
  pid->SetMode(AUTOMATIC);
  pid->SetOutputLimits(2, 60);
  
}
void AnalogPid::compute(){
  pid->Compute();
 
}
