lucailvec/thermore_insulating_machine/RTC_MESUREMENT_MACHINE_0_1/AnalogPid.h

#ifndef TEMPSENSOR_H
#define TEMPSENSOR_H
#include <PID_v1.h>

#ifndef Arduino_H
#include "Arduino.h"
#endif

class AnalogPid {
  public: AnalogPid(double *setpoint,double *output,double *mesure,double kp,double ki, double kd);
          PID * pid;//tramite l'esposizione del pid espongo tutto quello che mi serve
         void compute();
};

#endif
