lucailvec/thermore_insulating_machine/RTC_MESUREMENT_MACHINE_0_1/Fridge.cpp

#include "Fridge.h"
#ifndef Arduino_H
#include "Arduino.h"
#endif

Fridge::Fridge(int pin){
  _numPin=pin;
  pinMode(_numPin,OUTPUT);
  _onState = HIGH;
}

void Fridge::turn(Fridge::STATE st){
  if(st==Fridge::STATE::ON)
    digitalWrite(_numPin,(_onState)?HIGH:LOW);
  else
    digitalWrite(_numPin,(_onState)?LOW:HIGH);
  
}
