lucailvec/thermore_insulating_machine/(commit log)

2017-08-21 risolto problema su button causa else
    [Button.cpp, RTC_MESUREMENT_MACHINE_0_1.ino, include.h]
2017-08-22 analog pid and discrete, MUST modify button rules
2017-08-24 schermo, callback e aggiunta min e max su wrapper button
2017-08-24 sostituita media su somma di valori con mediana e sd con CV tramite quickstats
2017-09-09 aggiunta temporizzazione 200ms su sens di temp
2017-09-13 GREEN: nuova funzione clean, risolto problema di caricamento rct0\nabbassato I in pid
    [RTC_MESUREMENT_MACHINE_0_1.ino]
2017-10-05 stable code, must be refactored expectially on the useless print
